openenergymonitor/EmonGLCD/hardware/emonGLCD_V1.4.brd

## EAGLE design hardware/emonGLCD_V1.4.brd (2017-01-14, an earlier design)

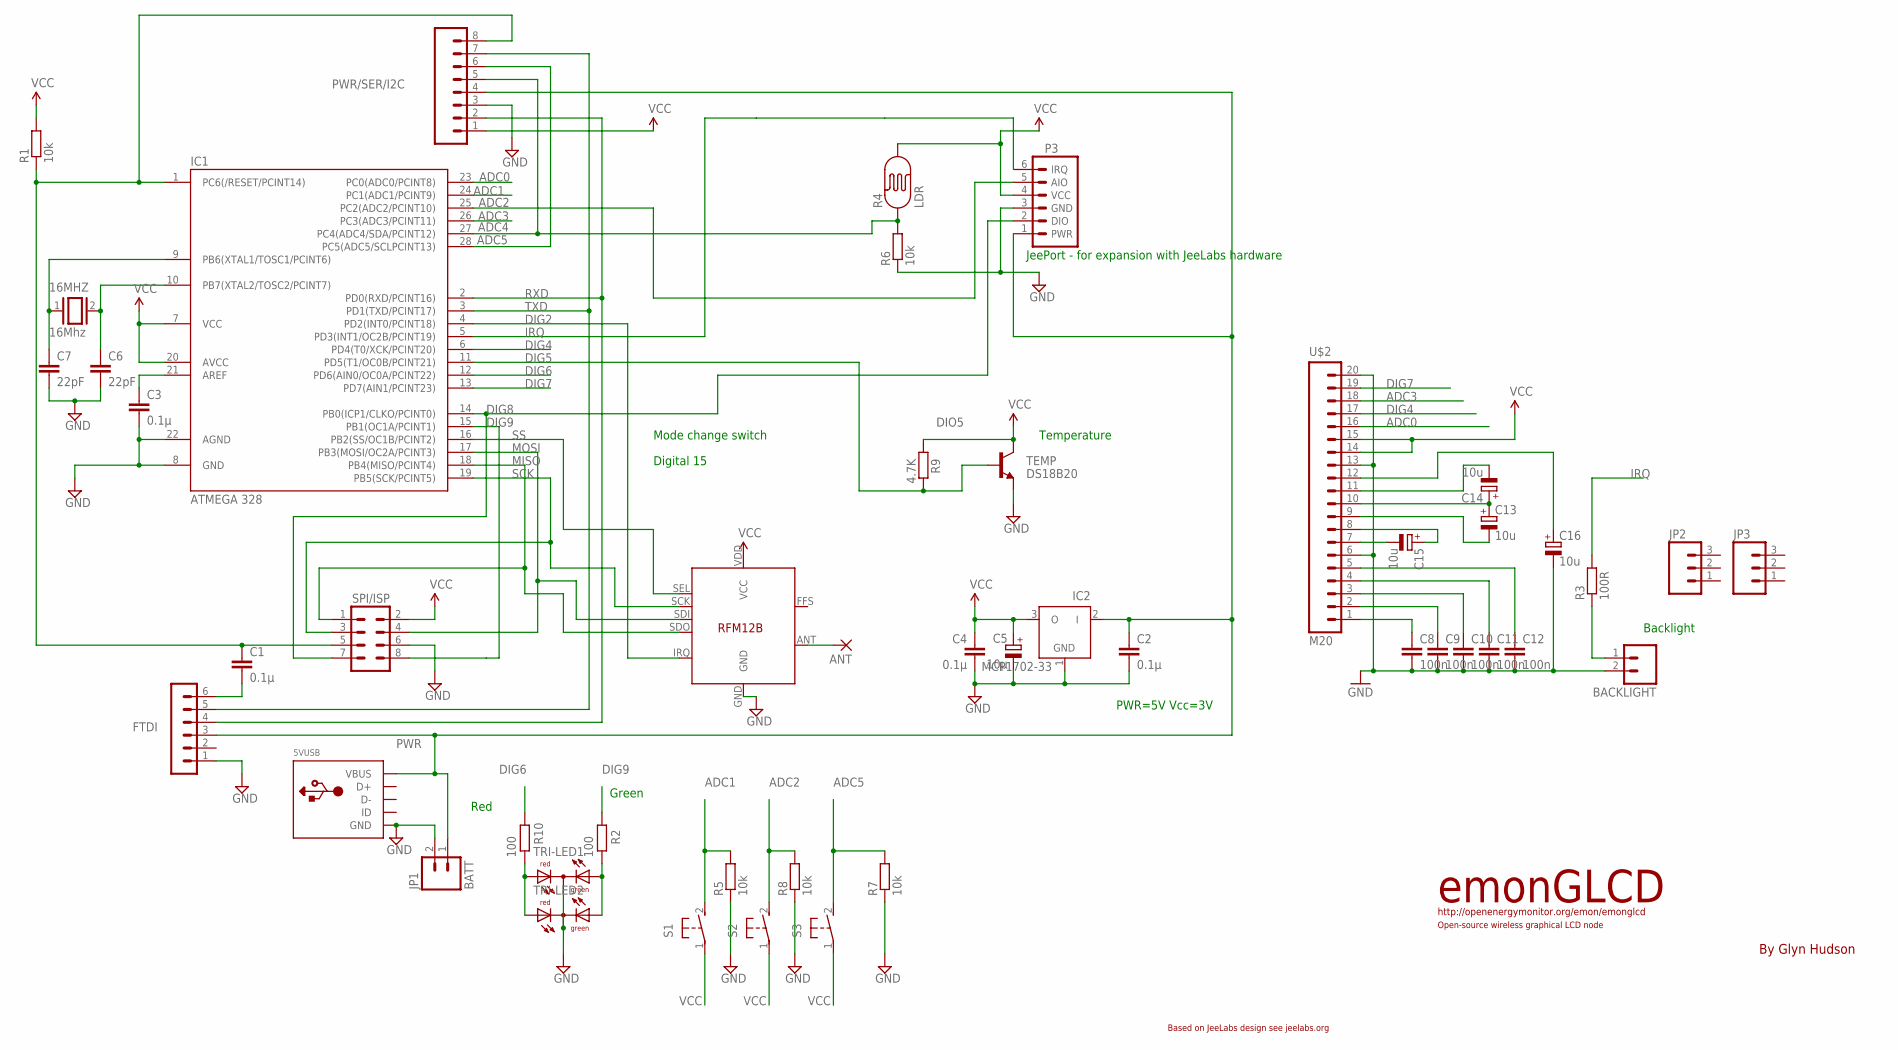
[picture p37: schematic emonGLCD_V1.4.sch]

Parts:
5VUSB: USBMOLEX; USB-MINIB-THM-MOLEX
16MHZ: 16Mhz; QS
ANT: 1,6/0,8
BACKLIGHT: M02PTH; 1X02
C1, C2, C3, C4: 0.1µ; C025-024X044
C5: 10µ; E1,8-4
C6, C7: 22pF; C2.5-2
C8, C9, C10, C11, C12: 100n; C2.5-2
C13, C14, C15, C16: 10u; E1,8-4
FTDI: FTDI; MA06-1
IC1: ATMEGA 328; DIL28-3
IC2: MCP1702-33; TO92
JP1: BATT; 1X02_LOCK_LONGPADS
JP2, JP3: M03PTH; 1X03
P3: JEEPORT; PORT6PIN
PWR/SER/I2C: M08; 1X08
R1, R5, R6, R7, R8: 10k; 0204/7
R2, R10: 100; 0204/7
R3: 100R; 0204/7
R4: LDR; PHOTOCELL
R9: 4.7K; 0204/7
S1, S2, S3: 31-XX; B3F-31XX
SV7: SPI/ISP; MA04-2
TEMP: DS18B20; TO-92
TRI-LED1, TRI-LED2: DUOLED5MM
U$1: RFM12B
U$2: M20; 1X20

Connections:
ADC0: IC1.23 (PC0(ADC0/PCINT8)), U$2.16
ADC1: IC1.24 (PC1(ADC1/PCINT9)), R5.2, S1.2 (S)
ADC2: IC1.25 (PC2(ADC2/PCINT10)), P3.5 (AIO), R8.2, S2.2 (S)
ADC3: IC1.26 (PC3(ADC3/PCINT11)), U$2.18
ADC4: IC1.27 (PC4(ADC4/SDA/PCINT12)), PWR/SER/I2C.5, R4.1, R6.2
ADC5: IC1.28 (PC5(ADC5/SCLPCINT13)), PWR/SER/I2C.6, R7.2, S3.2 (S)
DIG2: IC1.4 (PD2(INT0/PCINT18)), U$1.IRQ
DIG4: IC1.6 (PD4(T0/XCK/PCINT20)), U$2.17
DIG5: IC1.11 (PD5(T1/OC0B/PCINT21)), R9.2, TEMP.2 (B)
DIG6: IC1.12 (PD6(AIN0/OC0A/PCINT22)), R10.2
DIG7: IC1.13 (PD7(AIN1/PCINT23)), U$2.19
DIG8: IC1.14 (PB0(ICP1/CLKO/PCINT0)), P3.2 (DIO), SV7.7
DIG9: IC1.15 (PB1(OC1A/PCINT1)), R2.2, SV7.8
GND: 5VUSB.GND, BACKLIGHT.2, C2.2, C3.2, C4.2, C5.-, C6.2, C7.2, C8.2, C9.2, C10.2, C11.2, C12.2, C16.-, FTDI.1, IC1.8 (GND), IC1.22 (AGND), IC2.1 (GND), JP1.2, P3.3 (GND), PWR/SER/I2C.3, R5.1, R6.1, R7.1, R8.1, SV7.6, TEMP.1 (E), TRI-LED1.K (C), TRI-LED2.K (C), U$1.GND, U$2.6, U$2.13, U$2.20
IRQ: IC1.5 (PD3(INT1/OC2B/PCINT19)), P3.6 (IRQ), R3.2
MISO: IC1.18 (PB4(MISO/PCINT4)), SV7.1, U$1.SDO
MOSI: IC1.17 (PB3(MOSI/OC2A/PCINT3)), SV7.4, U$1.SDI
unnamed: 16MHZ.2, C6.1, IC1.10 (PB7(XTAL2/TOSC2/PCINT7))
unnamed: C8.1, U$2.1
unnamed: C9.1, U$2.2
unnamed: C10.1, U$2.3
unnamed: C11.1, U$2.4
unnamed: C12.1, U$2.5
unnamed: R10.1, TRI-LED1.AR, TRI-LED2.AR
unnamed: 16MHZ.1, C7.1, IC1.9 (PB6(XTAL1/TOSC1/PCINT6))
unnamed: ANT.1, U$1.ANT
unnamed: R2.1, TRI-LED1.AG, TRI-LED2.AG
unnamed: C1.2, FTDI.6
unnamed: BACKLIGHT.1, R3.1
unnamed: C3.1, IC1.21 (AREF)
unnamed: C14.-, U$2.11
unnamed: C13.+, C14.+, U$2.10
unnamed: C13.-, U$2.9
unnamed: C15.-, U$2.7
unnamed: C15.+, U$2.8
unnamed: C16.+, U$2.12
PWR: 5VUSB.VBUS, C2.1, FTDI.3, IC2.2 (I), JP1.1, P3.1 (PWR), PWR/SER/I2C.4
RST: C1.1, IC1.1 (PC6(/RESET/PCINT14)), PWR/SER/I2C.8, R1.1, SV7.5
RXD: FTDI.4, IC1.2 (PD0(RXD/PCINT16)), PWR/SER/I2C.2
SCK: IC1.19 (PB5(SCK/PCINT5)), SV7.3, U$1.SCK
SS: IC1.16 (PB2(SS/OC1B/PCINT2)), U$1.SEL
TXD: FTDI.5, IC1.3 (PD1(TXD/PCINT17)), PWR/SER/I2C.7
VCC: C4.1, C5.+, IC1.7 (VCC), IC1.20 (AVCC), IC2.3 (O), P3.4 (VCC), PWR/SER/I2C.1, R1.2, R4.2, R9.1, S1.1, S2.1, S3.1, SV7.2, TEMP.3 (C), U$1.VDD (VCC), U$2.14, U$2.15

Notes on the sheet:
PWR=5V Vcc=3V
Temperature
http://openenergymonitor.org/emon/emonglcd
Open-source wireless graphical LCD node
emonGLCD
By Glyn Hudson
Based on JeeLabs design see jeelabs.org
DIO5
Backlight
Mode change switch
Digital 15
JeePort - for expansion with JeeLabs hardware
Red
Green

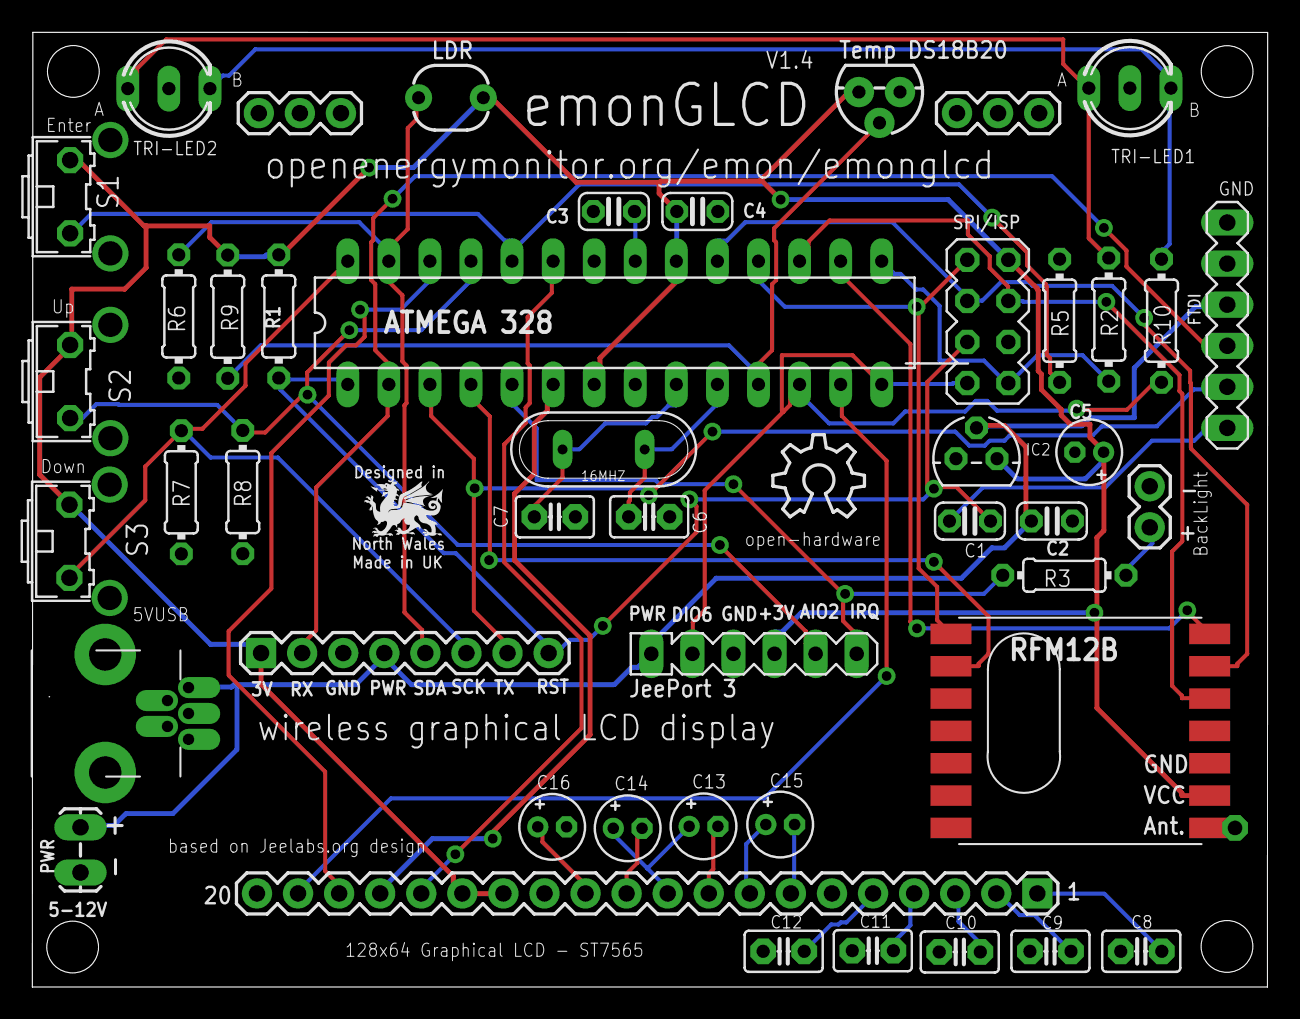
[picture p38: board emonGLCD_V1.4.brd from above]

Board: 2 copper layers, 76.4 x 59.0 mm, 48 parts (1 on the bottom side), 43 nets.

Other parts of the board:
U$3: Open-source Hardware; OSHW_8X200_NOTEXT
