openenergymonitor/EmonGLCD/(commit log)

2011-08-29 new example for emonGLCD, read from onboard temp sensor and first alpha code for changing color of tri colour LCD
2011-08-31 change comments to be inline with what currently on OEM get hub, automerge might now work?
2011-11-28 corrected error in pin number of digital pushswitch onboard
2011-12-26 changed location of Dallas temperature download
2011-12-26 updated examples to Arduino 1.0 and new JeeLabs libs Signed-off-by: Glyn Hudson <glyn.hudson@gmail.com>
2012-01-03 New EmonGLCD example - get time from server via nanoderf + relay temperature to nanoderf
2012-01-03 added #define DEBUG for printing
2012-01-06 New example for single CT that gets time update from internet via nanode temperature from emonglcd is also forwarded to the nanode
2012-01-24 added RF fail indicator to singe CT
    [display.ino]
2012-04-11 enabled software internal pull-up resistors to fix hardware switches
    [emonGLCD_SolarPV.ino]
2012-04-16 updated RF fail notificaion, enable switches, improve time display
    [display.ino, emonGLCD_HEM.ino, emonGLCD_SolarPV.ino]
2012-04-16 mirror time display fix to 2nd page of HEM
    [display.ino]
2012-04-29 improve emonTx & emonBase fail notifications - beta
    [display.ino]
2012-05-13 added smooth PWM LED indicator control to solar PV example, added LDR backlight level control
2012-05-13 changed default power channel for HEM example to be emonTx.power1 for CT connected to CH1
2012-05-13 set default rfm12b frequency back to 433, smapped round digitalWrites - improved stability?
    [display.ino, emonGLCD_SolarPV.ino]
2012-05-15 update examples to set current time to match computers time on sketch upload
2012-05-22 set current time on the emonGLCD to startup at mid-day by defaut
2012-05-25 remove serial printing of time seconds
2012-05-25 add red LED PWM control into Home Energy Monitor example
2012-07-19 New history display by vworp + links to dallas temperature github
2012-09-08 added support for solar PV type 2 and night time gen power level offset
2012-09-09 corrected error with type 2 monitoring
    corrected line 190 to be USE= (GRID + GEN) where grid is positive when importing
    [SolarPV.ino]
2012-09-09 update LED brightness mapping to use maxgen
    as defined at beginning of sketch, user is to set maxgen equal to PV array peak output
2012-09-09 fix use kwh total for type 2 solar
    [SolarPV.ino]
2012-09-10 updated LED's not to turn on until PV gen reaches offset level (default 20W)
2012-09-10 fix red LED not lighting up problem
    [SolarPV.ino, templates.ino]
2012-09-12 minor improve tx and base fail notifications
    [templates.ino]
2012-09-12 fix use kwh/d negative on type 2 solar issue
    [SolarPV.ino]
2012-09-16 add temp error checking and fix tx and base fail time run off display
    [SolarPV.ino, templates.ino]
2012-09-19 reduce max erroneous temperature
2012-10-31 fix bug to make switches work in tester sketch
    [tester.ino]
2012-11-15 remove history page to reduce sketch size to increase stability
    [SolarPV.ino, templates.ino]
2013-04-08 add new sendNow wrapper to solarPV example https://github.com/jcw/jeelib/issues/33
    [SolarPV.ino]
2013-04-08 fix error in last commit
    [SolarPV.ino]
2013-04-29 add delay to allow power supply to stabilise after power on before starting RF http://openenergymonitor.org/emon/node/1615
    [HomeEnergyMonitor.ino, SolarPV.ino]
2013-06-06 fix HEM example Kwh/d reset as midnight issue
    [HomeEnergyMonitor.ino]
2014-02-07 change 'freq' to 'RF_freq' to fix naming conflict with new JeeLib
    [HomeEnergyMonitor.ino, SolarPV.ino, serial.ino]
2015-03-05 Declare icons as const
    Variables going into progmem must be declared const when compiling in newer versions of the Arduino environment (e.g. 1.60),
    This addresses error message "error: variable 'icon_heating_8x16' must be const in order to be put into read-only section by means of '__attribute__((progmem))'" for example.
    [icons.ino]
2016-11-03 Added temperature/humidity display from on-board DHT
2017-01-14 move hardware from hardware repo
    [emonGLCD_V1.3.brd, emonGLCD_V1.3.sch, emonGLCD_V1.4.brd, emonGLCD_V1.4.sch, emonGLCD_V1.5.brd, emonGLCD_V1.5.sch]
2018-09-19 Fixed RTClib and glcdlib links
    [HomeEnergyMonitor.ino]
2018-11-25 Compatibility with EMONPI In EMONPI mode, a script is provided which is used to send updates to the display. This uses emonhub to send the data via RF. The advantage is that the script 'emonglcd-send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
    This is useful as it avoids having to use EMONTX and 'sniff' the data
    off the air. EMONHUB/EMONPI can maintain the solar PV and utility
    readings and calculate the Kwh. Any feeds or inputs can be sent to the
    display for these values.
    This is useful if you are using emonhub for aggregation purposes,
    potentially using other sources (modbus reading via external power
    meters or reading inver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
    [emonglcd-send.cfg]
2018-11-26 Added nodered flow to update emonGLCD display
2018-11-26 Node-red flow described
2018-11-26 Compiled version made available Re-enable LEDS off at night
2018-11-27 Fixed nasty bug when multiple emonGLCDs are used (the mqtt message is corrupted and keeps growing exponentially!)
    Fixed tiny bug in firmware in RF reception where one node could
    partially recieve another's data... (node checking nodeId correctly).
    (and yes, I just build my 2nd emonGLCD toaday so was able to properly
    test multiple operation!)
    [SolarPV.ino]
2018-11-28 Unit behaves slightly better in low light - generation LEDs go off and display brightness lower
2020-12-23 Now displays -- if the temp reading is not in range (eg no sensor connected) Bug fixed with time display when mins < 10 Bug fixed with util reading on 2nd screen (now shows grid reading as opposed to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
    [SolarPV.ino, templates.ino]
2020-12-25 Changed to allow full RTC usage and display date/time on the display Also added button 2 to toggle the PV Threshold between 0 & 10, effectively allowing the LEDs to show consumption at night time
    Needs a tidy up as will not function well if not using emonPI as the
    base (using an emonTX it does not have the day/mon/year to set the RTC)
    ^^DONE - should work with emonTx too (only display time)
2020-12-25 Fixed bugs related to sending to multiple EmonGLCDs Fixed issue where it may send (way) too often if either your power or solar readings are updated often Now sends the full date/time allowing the ne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
    [emonglcd-send.cfg]
2022-08-13 Updated cfg file comments
    [emonglcd-send.cfg]
